Oddsiee/Line-Follower-Demi-UAS-Sinsis/Documentation/PROJECT.md

# PROJECT — Kontrak Antarmuka & Aturan Tim

## Kontrak antarmuka (jangan diubah sepihak)
| Modul | Fungsi | Keterangan |
|---|---|---|
| sensor | `Sensor_ReadRaw(uint16_t raw[16])` | Nilai ADC mentah 16 channel |
| sensor | `Sensor_GetPosition()` | -7500..+7500, 0 = garis di tengah |
| sensor | `Sensor_LineVisible()` | false jika garis hilang |
| motor | `Motor_Set(int16_t kiri, int16_t kanan)` | -1000..+1000 |
| motor | `Motor_Brake()`, `Motor_Coast()` | Rem aktif / bebas |
| params | `Params_t` (params.h) | Kp, Ki, Kd, base/max speed, kalibrasi, flag invert |

Selama kontrak ini tetap, tiap orang boleh memakai stub modul lain.

## Alur data
```
Sensor_ReadRaw -> Calibration (normalisasi) -> Sensor_GetPosition
  -> PID -> Motor_Set
  Track (persimpangan/CP/invert) memodifikasi base speed & flag invert
  UI menampilkan data dan mengedit Params_t; Storage menyimpan ke Flash
```

## Pembagian modul
| Peran | File |
|---|---|
| A | sensor, calibration, pid, Tools/uart_plot.py |
| B | motor, Tests/test_motor, dokumen hardware & pengukuran |
| C | ui, buttons, storage, track, app, params.h |
| Bersama | config.h, .ioc, README.md |

## Hal yang wajib diingat (dari dokumentasi master)
- Sensor: PA0 = Out1 (`ADC1_IN0`), PA1 = Out2 (`ADC1_IN1`), PA2 = Out3 (`ADC1_IN2`), PA3 = In1 (GPIO output), PB0 = In2 (GPIO output), PB1 = Out4 (`ADC1_IN9`). Rank ADC mengikuti urutan kanal 0, 1, 2, 9; selektor mux memakai GPIOA dan GPIOB.
- Tombol UP/DOWN/OK/BACK: PA7/PA6/PA5/PA4; HARD RESET: R (NRST).
- OLED I2C1: PB7 = SDA, PB6 = SCL. Kabel power OLED sudah diperbaiki dan teruji normal (2026-11-13); jangan mengasumsikan VCC/GND tertukar lagi.
- **`I2C1` wajib `100 kHz` (`ClockSpeed = 100000`)**, bukan `400 kHz` (`PB6/SCL` mengandalkan internal pull-up STM32 ~40 kOhm, `g_i2c_pd = 0x80`). Tambahkan delay settling **`150 ms`** sebelum init OLED saat ditenagai buck converter `3.3 V`.
- **Arsitektur tombol & UI anti-blocking:** `SH1106_Update()` di `100 kHz` memblokir `main()` ~`110 ms`, sehingga pembacaan tombol (`PA7/PA6/PA5/PA4`) wajib disampling **`1 kHz` di `SysTick_Handler`** (`12 ms` debounce, `500 ms` long-press) + antrean FIFO 8-slot, dipasangkan dengan dirty-driven OLED refresh (`400 ms` layar statis, `80 ms` layar sensor live, timestamp dicatat setelah render).
- Driver motor D0/D1/D2/D3: PA8/PA9/PA10/PA11 (`TIM1_CH1–CH4`).
- OLED memakai **SH1106**, bukan SSD1306 (pakai U8g2).
- Pin `3V3` dan `VT` di header ZK-5AD **tidak disambung**.
- Rem aktif = kedua pin driver HIGH; coast = kedua LOW.
- Batas regulasi: 20x20x10 cm, 3 kg, baterai 12 V +-1,5 V.
- PA11 tetap PWM motor kanan IN2; USB data tidak digunakan bersamaan dengan PWM pada pin ini. Flash/debug melalui SWD.

## Keputusan terbuka
- [ ] Verifikasi PA11 sebagai PWM motor dan konfigurasi USB data nonaktif (M1.3)
- [ ] Frekuensi PWM motor (M3.1)
- [ ] Periode loop kontrol (M8.1)
