Oddsiee/Line-Follower-Demi-UAS-Sinsis/Documentation/Milestones/M03_Driver.md

# Milestone 3 — Driver Motor

- **Pemilik:** B
- **Jadwal:** 7–11 Nov
- **Status:** belum mulai

## Tujuan
(isi satu-dua kalimat)

## Sub-milestone
- [ ] M3.1 Konfigurasi TIM1_CH1–CH4 pada PA8/PA9/PA10/PA11 untuk D0/D1/D2/D3; pilih frekuensi (coba 10–20 kHz)
- [ ] M3.2 Fungsi maju, mundur, rem aktif (kedua pin HIGH), coast (kedua pin LOW)
- [ ] M3.3 Motor_Set(kiri, kanan) dengan clamp -1000..+1000
- [ ] M3.4 Uji roda terangkat: arah putar benar, kiri/kanan tidak tertukar

## Selesai kalau
Kedua motor bisa dikontrol penuh lewat satu fungsi.

## Langkah yang dikerjakan
(catat langkah penting, setting CubeMX, library yang dipakai)

## Hasil uji
| Uji | Hasil | Catatan |
|---|---|---|
| | | |

## Masalah & solusi
- 

## Catatan untuk milestone berikutnya
-
