Oddsiee/Line-Follower-Demi-UAS-Sinsis/Documentation/Milestones/M06_Karakterisasi.md

# Milestone 6 — Karakterisasi Motor

- **Pemilik:** B
- **Jadwal:** 12–16 Nov
- **Status:** belum mulai

## Tujuan
(isi satu-dua kalimat)

## Sub-milestone
- [ ] M6.1 Ukur deadband (PWM minimum agar roda berputar) dan kompensasi
- [ ] M6.2 Seimbangkan kiri-kanan agar lurus saat perintah sama
- [ ] M6.3 Ramp akselerasi dan cek lonjakan arus saat stall
- [ ] M6.4 Safe-stop (rem) lewat satu fungsi; uji LiPo 3S saat beban

## Selesai kalau
Robot jalan lurus di lantai dan berhenti dengan baik.

## Langkah yang dikerjakan
(catat langkah penting, setting CubeMX, library yang dipakai)

## Hasil uji
| Uji | Hasil | Catatan |
|---|---|---|
| | | |

## Masalah & solusi
- 

## Catatan untuk milestone berikutnya
-
