Oddsiee/Line-Follower-Demi-UAS-Sinsis/Documentation/Milestones/M08_Integrasi.md

# Milestone 8 — Integrasi PID

- **Pemilik:** A (B, C mendukung)
- **Jadwal:** 17–21 Nov
- **Status:** belum mulai

## Tujuan
(isi satu-dua kalimat)

## Sub-milestone
- [ ] M8.1 Loop kontrol periode tetap (timer interrupt, mulai 2–5 ms)
- [ ] M8.2 PID: error = posisi, output dibagi ke motor kiri/kanan di sekitar base speed
- [ ] M8.3 Tuning awal: garis lurus lalu belokan landai (Kp, lalu Kd, lalu Ki kecil/nol)
- [ ] M8.4 Tampilkan data live (posisi, error, speed) di OLED

## Selesai kalau
Robot mengikuti lintasan sederhana satu putaran penuh.

## Langkah yang dikerjakan
(catat langkah penting, setting CubeMX, library yang dipakai)

## Hasil uji
| Uji | Hasil | Catatan |
|---|---|---|
| | | |

## Masalah & solusi
- 

## Catatan untuk milestone berikutnya
-
