Oddsiee/Line-Follower-Demi-UAS-Sinsis/Documentation/Milestones/M11_Pengujian.md

# Milestone 11 — Pengujian & Regulasi

- **Pemilik:** Semua
- **Jadwal:** 25–26 Nov
- **Status:** belum mulai

## Tujuan
(isi satu-dua kalimat)

## Sub-milestone
- [ ] M11.1 Cek dimensi (maks 20x20x10 cm), berat (maks 3 kg), tegangan baterai (12 V +-1,5 V)
- [ ] M11.2 Simulasi lomba: waktu terbatas, mulai dari menu
- [ ] M11.3 Uji ketahanan: cahaya berbeda dan baterai setengah habis

## Selesai kalau
Robot lolos cek regulasi dan simulasi. 27 Nov: freeze firmware.

## Langkah yang dikerjakan
(catat langkah penting, setting CubeMX, library yang dipakai)

## Hasil uji
| Uji | Hasil | Catatan |
|---|---|---|
| | | |

## Masalah & solusi
- 

## Catatan untuk milestone berikutnya
-
