Oddsiee/Line-Follower-Demi-UAS-Sinsis/Documentation/Milestones/M07_Parameter.md

# Milestone 7 — Parameter & Penyimpanan

- **Pemilik:** C
- **Jadwal:** 12–16 Nov
- **Status:** belum mulai

## Tujuan
(isi satu-dua kalimat)

## Sub-milestone
- [ ] M7.1 Layar edit Kp, Ki, Kd, base speed, max speed
- [ ] M7.2 Simpan Params & kalibrasi ke sektor Flash terakhir (sektor 7); tulis hanya saat IDLE
- [ ] M7.3 Muat otomatis saat boot, validasi magic number / checksum
- [ ] M7.4 State machine: IDLE -> CALIB -> READY -> RUN -> STOP

## Selesai kalau
Parameter tetap tersimpan setelah power off.

## Langkah yang dikerjakan
(catat langkah penting, setting CubeMX, library yang dipakai)

## Hasil uji
| Uji | Hasil | Catatan |
|---|---|---|
| | | |

## Masalah & solusi
- 

## Catatan untuk milestone berikutnya
-
