Oddsiee/Line-Follower-Demi-UAS-Sinsis/Documentation/Milestones/M09_Logika.md

# Milestone 9 — Logika Lintasan

- **Pemilik:** C (A mendukung, B lintasan uji)
- **Jadwal:** 17–21 Nov
- **Status:** belum mulai

## Tujuan
(isi satu-dua kalimat)

## Sub-milestone
- [ ] M9.1 Deteksi persimpangan dan percabangan
- [ ] M9.2 Indexing path / checkpoint CP 1–4
- [ ] M9.3 Mode invert untuk blok "TED 2026" dan petir
- [ ] M9.4 Lintasan uji sesuai guidebook dan profil kecepatan

## Selesai kalau
Satu putaran lintasan lengkap selesai, walau belum cepat.

## Langkah yang dikerjakan
(catat langkah penting, setting CubeMX, library yang dipakai)

## Hasil uji
| Uji | Hasil | Catatan |
|---|---|---|
| | | |

## Masalah & solusi
- 

## Catatan untuk milestone berikutnya
-
