Oddsiee/Line-Follower-Demi-UAS-Sinsis/Documentation/Milestones/M01_Bring-up.md

# Milestone 1 — Bring-up Hardware

- **Pemilik:** Semua
- **Jadwal:** 4–6 Nov
- **Status:** belum mulai

## Tujuan
(isi satu-dua kalimat)

## Sub-milestone
- [x] M1.1 Buat `.ioc` sesuai pinout master (ADC1 PA0/PA1/PA2/PB1 pada IN0/IN1/IN2/IN9 untuk Out1–Out4, GPIO PA3=In1 dan PB0=In2, TIM1 PA8–PA11, I2C1 PB6=SCL/PB7=SDA, tombol UP/DOWN/OK/BACK di PA7/PA6/PA5/PA4, reset R/NRST, USART1 debug)
- [ ] M1.2 Cek rail 3V3, GND, polaritas sebelum baterai dipasang; pin 3V3 & VT ZK-5AD tetap NC
- [ ] M1.3 Verifikasi PA11 tetap sebagai TIM1_CH4 (DRV_D3); nonaktifkan USB data saat PWM motor digunakan dan gunakan SWD untuk flash/debug
- [ ] M1.4 Uji flash via SWD dan UART debug

## Selesai kalau
Firmware kosong ter-flash dan UART mencetak teks uji.

## Langkah yang dikerjakan
(catat langkah penting, setting CubeMX, library yang dipakai)

## Hasil uji
| Uji | Hasil | Catatan |
|---|---|---|
| | | |

## Masalah & solusi
- 

## Catatan untuk milestone berikutnya
-
