Oddsiee/Line-Follower-Demi-UAS-Sinsis/Documentation/Milestones/M10_Tuning.md

# Milestone 10 — Tuning Lintasan

- **Pemilik:** Semua
- **Jadwal:** 22–25 Nov
- **Status:** belum mulai

## Tujuan
(isi satu-dua kalimat)

## Sub-milestone
- [ ] M10.1 A: tuning PID dan kecepatan maksimum
- [ ] M10.2 B: mekanik (tinggi sensor, bobot, roda) dan konsistensi baterai
- [ ] M10.3 C: catat hasil tiap run dan simpan beberapa profil parameter
- [ ] M10.4 Uji berulang minimal 10x tanpa keluar jalur

## Selesai kalau
10 run berturut-turut stabil.

## Langkah yang dikerjakan
(catat langkah penting, setting CubeMX, library yang dipakai)

## Hasil uji
| Uji | Hasil | Catatan |
|---|---|---|
| | | |

## Masalah & solusi
- 

## Catatan untuk milestone berikutnya
-
