Oddsiee/Line-Follower-Demi-UAS-Sinsis/Documentation/Milestones/M05_Kalibrasi.md

# Milestone 5 — Kalibrasi & Posisi Garis

- **Pemilik:** A
- **Jadwal:** 12–16 Nov
- **Status:** belum mulai

## Tujuan
(isi satu-dua kalimat)

## Sub-milestone
- [ ] M5.1 Rutinitas kalibrasi: sapu hitam dan putih, simpan min/max tiap channel
- [ ] M5.2 Threshold / normalisasi 0–1000 per channel
- [ ] M5.3 Posisi garis dengan weighted average 16 channel (pusat = 0)
- [ ] M5.4 Penanganan garis hilang (ingat arah terakhir) dan mode invert

## Selesai kalau
Posisi bergerak mulus saat garis digeser manual, termasuk mode invert.

## Langkah yang dikerjakan
(catat langkah penting, setting CubeMX, library yang dipakai)

## Hasil uji
| Uji | Hasil | Catatan |
|---|---|---|
| | | |

## Masalah & solusi
- 

## Catatan untuk milestone berikutnya
-
