Oddsiee/Line-Follower-Demi-UAS-Sinsis/Firmware/LF_TED2026/Tes_Oled_Sensor_Baru.ioc

Mcu.UserName=STM32F411CEUx
PA0-WKUP.Signal=ADCx_IN0
PA1.Signal=ADCx_IN1
PA10.Signal=S_TIM1_CH3
PA11.Signal=S_TIM1_CH4
PA13.Signal=SYS_JTMS-SWDIO
PA14.Signal=SYS_JTCK-SWCLK
PA15.Signal=USART1_TX
PA2.Signal=ADCx_IN2
PA3.Signal=GPIO_Output
PA4.Signal=GPIO_Input
PA5.Signal=GPIO_Input
PA6.Signal=GPIO_Input
PA7.Signal=GPIO_Input
PA8.Signal=S_TIM1_CH1
PA9.Signal=S_TIM1_CH2
PB0.Signal=GPIO_Output
PB1.Signal=ADCx_IN9
PB3.Signal=USART1_RX
PB6.Signal=I2C1_SCL
PB7.Signal=I2C1_SDA
PC13-ANTI_TAMP.Signal=GPIO_Output
