Oddsiee/Line-Follower-Demi-UAS-Sinsis/Firmware/LF_TED2026/Core/Src/sh1106.c

#include "sh1106.h"
#include "stm32f4xx_hal.h"
#include <stddef.h>

/* Handle I2C dari CubeMX (default hi2c1, global di main.c). */
extern I2C_HandleTypeDef SH1106_HI2C;

#define SH1106_TIMEOUT 100U

/* Framebuffer: 8 halaman x 128 kolom. 1 byte = 8 piksel vertikal,
 * bit 0 = piksel paling atas dalam halaman. */
static uint8_t s_fb[8][SH1106_WIDTH];
static uint8_t s_addr7 = SH1106_I2C_ADDR;

/* Statistik untuk diagnosa (bisa dibaca via SWD). */
volatile uint32_t g_sh1106_ok   = 0;
volatile uint32_t g_sh1106_fail = 0;
volatile uint32_t g_sh1106_last = 0;
volatile uint32_t g_sh1106_recover = 0;
volatile uint32_t g_sh1106_scan_count = 0;
volatile uint32_t g_sh1106_scan_lo = 0;
volatile uint32_t g_sh1106_scan_hi = 0;

/* ============================================================
 * Font 6x8 (ASCII 32..126). 6 byte/glyph = 6 kolom, bit 0 = baris atas.
 * Di-generate oleh Tools/gen_font.py (Consolas, supersampled).
 * ============================================================ */
static const uint8_t FONT6x8[95][6] = {
    {0x00, 0x00, 0x00, 0x00, 0x00, 0x00}, /*  32 ' ' */
    {0x00, 0x00, 0x9F, 0x00, 0x00, 0x00}, /*  33 '!' */
    {0x3C, 0x3C, 0x00, 0x00, 0x3C, 0x3C}, /*  34 '\"' */
    {0x10, 0x7E, 0x17, 0x74, 0x1F, 0x00}, /*  35 '#' */
    {0x00, 0x44, 0xCA, 0x5B, 0x30, 0x00}, /*  36 '$' */
    {0x42, 0x25, 0x13, 0x64, 0x52, 0x21}, /*  37 '%' */
    {0x30, 0x4F, 0x4D, 0x77, 0x70, 0x00}, /*  38 '&' */
    {0x00, 0xFF, 0xFF, 0xFF, 0x03, 0x00}, /*  39 '\'' */
    {0x00, 0x00, 0x3C, 0x81, 0x00, 0x00}, /*  40 '(' */
    {0x00, 0x00, 0x81, 0x3C, 0x00, 0x00}, /*  41 ')' */
    {0x24, 0x18, 0x7E, 0x18, 0x18, 0x24}, /*  42 '*' */
    {0x10, 0x18, 0x7E, 0x7E, 0x18, 0x10}, /*  43 '+' */
    {0x40, 0x60, 0x62, 0x3F, 0x1F, 0x0E}, /*  44 ',' */
    {0x08, 0x08, 0x08, 0x08, 0x08, 0x08}, /*  45 '-' */
    {0x38, 0x7C, 0x7E, 0x7E, 0x3C, 0x18}, /*  46 '.' */
    {0x00, 0x80, 0x30, 0x0C, 0x01, 0x00}, /*  47 '/' */
    {0x7E, 0xF3, 0x99, 0xCF, 0x7E, 0x00}, /*  48 '0' */
    {0x82, 0x83, 0xFF, 0x80, 0x80, 0x00}, /*  49 '1' */
    {0x80, 0xC1, 0xB1, 0x9F, 0x84, 0x00}, /*  50 '2' */
    {0x00, 0x81, 0x89, 0x99, 0x76, 0x00}, /*  51 '3' */
    {0x10, 0x1C, 0x26, 0x33, 0x7F, 0x00}, /*  52 '4' */
    {0x00, 0x8F, 0x89, 0xC9, 0x71, 0x00}, /*  53 '5' */
    {0x7C, 0xCA, 0x89, 0x89, 0x70, 0x00}, /*  54 '6' */
    {0x01, 0xC1, 0x71, 0x0D, 0x03, 0x00}, /*  55 '7' */
    {0x66, 0x9D, 0x89, 0x99, 0x66, 0x00}, /*  56 '8' */
    {0x0E, 0x91, 0x91, 0x53, 0x3E, 0x00}, /*  57 '9' */
    {0x00, 0x00, 0xC3, 0xC3, 0x00, 0x00}, /*  58 ':' */
    {0x00, 0x00, 0x80, 0x73, 0x00, 0x00}, /*  59 ';' */
    {0x18, 0x18, 0x24, 0x42, 0x81, 0x00}, /*  60 '<' */
    {0x14, 0x14, 0x14, 0x14, 0x14, 0x14}, /*  61 '=' */
    {0x81, 0x42, 0x24, 0x18, 0x18, 0x00}, /*  62 '>' */
    {0x00, 0x91, 0x99, 0x0E, 0x00, 0x00}, /*  63 '?' */
    {0x00, 0x78, 0xA1, 0x25, 0x1E, 0x00}, /*  64 '@' */
    {0x60, 0x3C, 0x33, 0x33, 0x3C, 0x60}, /*  65 'A' */
    {0xFF, 0x99, 0x89, 0xDB, 0x76, 0x00}, /*  66 'B' */
    {0x3C, 0xC2, 0x81, 0x81, 0x81, 0x00}, /*  67 'C' */
    {0xFF, 0x81, 0x81, 0xC3, 0x3E, 0x00}, /*  68 'D' */
    {0x00, 0xFF, 0x89, 0x89, 0x89, 0x00}, /*  69 'E' */
    {0x00, 0xFF, 0x19, 0x19, 0x01, 0x00}, /*  70 'F' */
    {0x7C, 0xC3, 0x81, 0x99, 0xF1, 0x00}, /*  71 'G' */
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
};

/* ============================================================
 * I2C low-level
 * ============================================================ */

/* ============================================================
 * Bus recovery
 *
 * Masalah nyata yang terukur: flag BUSY di I2C1 bisa macet permanen
 * (SR2.BUSY = 1) sehingga SEMUA transaksi mengembalikan HAL_BUSY.
 * __HAL_RCC_I2C1_FORCE_RESET() saja TIDAK cukup untuk membersihkannya.
 * Yang terbukti bekerja: bit SWRST di I2C_CR1.
 *
 * Urutan:
 *   1. Lepas pin dari AF -> GPIO open-drain, clock SCL 9x (bebaskan slave
 *      yang menahan SDA), lalu STOP.
 *   2. SWRST pulse untuk reset state machine peripheral.
 *   3. Kembalikan pin ke AF4, init ulang HAL.
 *   4. Verifikasi SR2.BUSY == 0; ulangi bila perlu.
 * ============================================================ */
static void i2c_swrst(void)
{
    /* RM0090: SWRST hanya bisa di-set saat peripheral DISABLE (PE=0).
     * Kalau PE masih 1, tulisan SWRST DIABAIKAN dan flag BUSY tetap macet.
     * Urutan wajib: PE=0 -> SWRST=1 -> SWRST=0 -> PE=1. */
    I2C_TypeDef *i2c = SH1106_HI2C.Instance;

    i2c->CR1 &= ~I2C_CR1_PE;          /* 1. disable peripheral */
    for (volatile int d = 0; d < 50; d++) { }

    i2c->CR1 |=  I2C_CR1_SWRST;       /* 2. reset state machine */
    for (volatile int d = 0; d < 50; d++) { }

    i2c->CR1 &= ~I2C_CR1_SWRST;       /* 3. lepas reset */
    for (volatile int d = 0; d < 50; d++) { }

    i2c->CR1 |=  I2C_CR1_PE;          /* 4. enable kembali */
    for (volatile int d = 0; d < 50; d++) { }
}

static void i2c_bus_recover(void)
{
    GPIO_InitTypeDef g = {0};

    /* --- 1. bit-bang: lepas slave yang menahan SDA --- */
    g.Pin       = GPIO_PIN_6 | GPIO_PIN_7;
    g.Mode      = GPIO_MODE_OUTPUT_OD;
    g.Pull      = GPIO_PULLUP;
    g.Speed     = GPIO_SPEED_FREQ_VERY_HIGH;
    HAL_GPIO_Init(GPIOB, &g);

    HAL_GPIO_WritePin(GPIOB, GPIO_PIN_7, GPIO_PIN_SET);   /* SDA high */
    for (int i = 0; i < 9; i++) {
        HAL_GPIO_WritePin(GPIOB, GPIO_PIN_6, GPIO_PIN_RESET);
        for (volatile int d = 0; d < 200; d++) { }
        HAL_GPIO_WritePin(GPIOB, GPIO_PIN_6, GPIO_PIN_SET);
        for (volatile int d = 0; d < 200; d++) { }
    }
    /* kondisi STOP: SDA low -> SCL high -> SDA high */
    HAL_GPIO_WritePin(GPIOB, GPIO_PIN_7, GPIO_PIN_RESET);
    for (volatile int d = 0; d < 200; d++) { }
    HAL_GPIO_WritePin(GPIOB, GPIO_PIN_6, GPIO_PIN_SET);
    for (volatile int d = 0; d < 200; d++) { }
    HAL_GPIO_WritePin(GPIOB, GPIO_PIN_7, GPIO_PIN_SET);
    for (volatile int d = 0; d < 200; d++) { }

    /* --- 2. reset peripheral (SWRST terbukti membersihkan BUSY) --- */
    i2c_swrst();

    /* --- 3. kembalikan pin ke AF4 I2C1 --- */
    g.Mode      = GPIO_MODE_AF_OD;
    g.Alternate = GPIO_AF4_I2C1;
    HAL_GPIO_Init(GPIOB, &g);

    /* --- 4. init ulang HAL + verifikasi BUSY hilang --- */
    SH1106_HI2C.State = HAL_I2C_STATE_RESET;
    HAL_I2C_Init(&SH1106_HI2C);

    for (int t = 0; t < 3; t++) {
        if ((SH1106_HI2C.Instance->SR2 & I2C_SR2_BUSY) == 0U) break;
        i2c_swrst();
        SH1106_HI2C.State = HAL_I2C_STATE_RESET;
        HAL_I2C_Init(&SH1106_HI2C);
    }
}

/* Scan bus I2C 0x08..0x77. Bit i = alamat (0x08+i) untuk i<0x38,
 * sisanya di *hi. Mengembalikan jumlah device yang ACK. */
uint32_t SH1106_Scan(uint32_t *lo, uint32_t *hi)
{
    uint32_t n = 0;
    if (lo) *lo = 0;
    if (hi) *hi = 0;

    for (uint8_t a = 0x08; a <= 0x77; a++) {
        if (HAL_I2C_IsDeviceReady(&SH1106_HI2C, (uint16_t)(a << 1), 2, 10) == HAL_OK) {
            if (a < 0x40) { if (lo) *lo |= (1UL << (a - 0x08)); }
            else          { if (hi) *hi |= (1UL << (a - 0x40)); }
            n++;
        }
    }
    return n;
}

static void write_cmd(uint8_t cmd)
{
    /* control byte 0x00 = perintah */
    HAL_StatusTypeDef st = HAL_I2C_Mem_Write(&SH1106_HI2C, (uint16_t)(s_addr7 << 1), 0x00,
                                             I2C_MEMADD_SIZE_8BIT, &cmd, 1, SH1106_TIMEOUT);

    /* BUSY macet = peripheral perlu di-recover, bukan sekadar retry. */
    if (st == HAL_BUSY) {
        g_sh1106_recover++;
        i2c_bus_recover();
        st = HAL_I2C_Mem_Write(&SH1106_HI2C, (uint16_t)(s_addr7 << 1), 0x00,
                               I2C_MEMADD_SIZE_8BIT, &cmd, 1, SH1106_TIMEOUT);
    }

    g_sh1106_last = (uint32_t)st;
    if (st == HAL_OK) g_sh1106_ok++; else g_sh1106_fail++;
}

static void write_data(const uint8_t *data, uint16_t len)
{
    /* control byte 0x40 = data */
    HAL_I2C_Mem_Write(&SH1106_HI2C, (uint16_t)(s_addr7 << 1), 0x40,
                      I2C_MEMADD_SIZE_8BIT, (uint8_t *)data, len, SH1106_TIMEOUT);
}

/* ============================================================
 * Init
 * ============================================================ */
void SH1106_Init(void)
{
    /* Kalau MCU reset di tengah transaksi I2C, slave bisa menahan SDA LOW
     * dan flag BUSY jadi macet. Recover dulu sebelum init. */
    i2c_bus_recover();

    /* Jika gambar terbalik/mirror, tukar 0xA1<->0xA0 dan 0xC8<->0xC0. */
    static const uint8_t init[] = {
        0xAE,          /* display off                  */
        0xD5, 0x80,    /* clock divide ratio           */
        0xA8, 0x3F,    /* multiplex ratio = 64         */
        0xD3, 0x00,    /* display offset = 0           */
        0x40,          /* start line = 0               */
        0xAD, 0x8B,    /* charge pump ON (khas SH1106) */
        0xA1,          /* segment remap                */
        0xC8,          /* COM scan direction remapped  */
        0xDA, 0x12,    /* COM pins hardware config     */
        0x81, 0xCF,    /* contrast                     */
        0xD9, 0x22,    /* pre-charge period            */
        0xDB, 0x35,    /* VCOM deselect level          */
        0xA4,          /* resume dari all-on           */
        0xA6,          /* normal (bukan invert)        */
        0xAF           /* display on                   */
    };
    for (size_t i = 0; i < sizeof(init) / sizeof(init[0]); i++) {
        write_cmd(init[i]);
    }
    SH1106_Clear();
    SH1106_Update();
}

void SH1106_Clear(void)
{
    for (int p = 0; p < 8; p++) {
        for (int x = 0; x < SH1106_WIDTH; x++) {
            s_fb[p][x] = 0x00;
        }
    }
}

void SH1106_Update(void)
{
    for (uint8_t page = 0; page < 8; page++) {
        write_cmd((uint8_t)(0xB0 | page));  /* set page address        */
        write_cmd(0x02);                    /* kolom bawah = 2         */
        write_cmd(0x10);                    /* kolom atas  = 0         */
        write_data(s_fb[page], SH1106_WIDTH);
    }
}

bool SH1106_Probe(uint8_t addr7)
{
    return HAL_I2C_IsDeviceReady(&SH1106_HI2C, (uint16_t)(addr7 << 1), 2, 10)
           == HAL_OK;
}

void SH1106_SetAddress(uint8_t addr7)
{
    s_addr7 = addr7;
}

/* ============================================================
 * Drawing
 * ============================================================ */
void SH1106_SetPixel(int x, int y, bool on)
{
    if (x < 0 || x >= SH1106_WIDTH || y < 0 || y >= SH1106_HEIGHT) return;
    uint8_t page = (uint8_t)(y >> 3);
    uint8_t bit  = (uint8_t)(1U << (y & 7));
    if (on) s_fb[page][x] |=  bit;
    else    s_fb[page][x] &= (uint8_t)~bit;
}

void SH1106_DrawLine(int x0, int y0, int x1, int y1, bool on)
{
    int dx = x1 > x0 ? x1 - x0 : x0 - x1;
    int dy = y1 > y0 ? y1 - y0 : y0 - y1;
    int sx = x0 < x1 ? 1 : -1;
    int sy = y0 < y1 ? 1 : -1;
    int err = dx - dy;

    for (;;) {
        SH1106_SetPixel(x0, y0, on);
        if (x0 == x1 && y0 == y1) break;
        int e2 = 2 * err;
        if (e2 > -dy) { err -= dy; x0 += sx; }
        if (e2 <  dx) { err += dx; y0 += sy; }
    }
}

void SH1106_DrawRect(int x, int y, int w, int h, bool on)
{
    SH1106_DrawLine(x,     y,     x + w - 1, y,         on);
    SH1106_DrawLine(x,     y + h - 1, x + w - 1, y + h - 1, on);
    SH1106_DrawLine(x,     y,     x,     y + h - 1, on);
    SH1106_DrawLine(x + w - 1, y, x + w - 1, y + h - 1, on);
}

void SH1106_DrawFillRect(int x, int y, int w, int h, bool on)
{
    for (int yy = y; yy < y + h; yy++) {
        SH1106_DrawLine(x, yy, x + w - 1, yy, on);
    }
}

void SH1106_DrawCircle(int cx, int cy, int r, bool on)
{
    int x = 0, y = r, d = 3 - 2 * r;
    while (y >= x) {
        SH1106_SetPixel(cx + x, cy + y, on);
        SH1106_SetPixel(cx - x, cy + y, on);
        SH1106_SetPixel(cx + x, cy - y, on);
        SH1106_SetPixel(cx - x, cy - y, on);
        SH1106_SetPixel(cx + y, cy + x, on);
        SH1106_SetPixel(cx - y, cy + x, on);
        SH1106_SetPixel(cx + y, cy - x, on);
        SH1106_SetPixel(cx - y, cy - x, on);
        if (d < 0) {
            d += 4 * x + 6;
        } else {
            d += 4 * (x - y) + 10;
            y--;
        }
        x++;
    }
}

void SH1106_DrawFillCircle(int cx, int cy, int r, bool on)
{
    for (int y = -r; y <= r; y++) {
        int half = 0;
        while ((half + 1) * (half + 1) + y * y <= r * r) half++;
        SH1106_DrawLine(cx - half, cy + y, cx + half, cy + y, on);
    }
}

void SH1106_DrawChar(int x, int y, char c)
{
    int idx = (int)c - 32;
    if (idx < 0 || idx >= 95) idx = 0;   /* karakter di luar tabel -> spasi */
    for (int col = 0; col < 6; col++) {
        uint8_t bits = FONT6x8[idx][col];
        for (int row = 0; row < 8; row++) {
            if (bits & (1U << row)) {
                SH1106_SetPixel(x + col, y + row, true);
            }
        }
    }
}

void SH1106_DrawString(int x, int y, const char *s)
{
    while (*s) {
        SH1106_DrawChar(x, y, *s++);
        x += 6;
    }
}
