Oddsiee/Line-Follower-Demi-UAS-Sinsis/(commit log)

2026-11-02 Add Workspace STM32
2026-11-04 Upload file line track
2026-11-05 [M4] ui: test OLED SH1106 (driver HAL + demo + docs)
2026-11-05 Driver SH1106
2026-11-05 feat(tests): standalone OLED test buildable without CubeIDE
    - Tests/test_oled: main.c, hal_conf, it.c, linker script
    - build.ps1: compile+link with bundled ARM GCC, no CubeIDE needed
    - flash.ps1: flash via STM32_Programmer_CLI (SWD, verify, reset)
    - Verified: text 11820B, flashed & verified on STM32F411CEU6
    - TEST_OLED.md: document firmware package workaround (st.com unreachable)
    - .gitignore: ignore build/, *.hex, *.bin
    [main.c]
2026-11-05 test(oled): hardware diagnostics — OLED not detected on I2C bus
    Measured directly from MCU registers via SWD:
    - I2C scan 0x08..0x77 on 5 buses (bitbang PB6/7, I2C1 PB6/7, I2C1 PB8/9,
    I2C2 PB10/11, I2C3 PA8/PC9): 0 devices found
    - Pin test: MCU can drive HIGH (0xC0) and LOW (0x00) — pins healthy
    - Pull-down test: lines read LOW => NO external pull-up on bus
    - Pull-up test: lines read HIGH => no short to GND
    Conclusion: physical/electrical issue, not firmware.
    Likely: OLED unpowered, pin order reversed (GND-VCC vs VCC-GND), or dead module.
    Added: diag_main.c, pin_test.c, multibus.c, pullup_test.c + runner scripts
    Added: DIAGNOSA.md with measurements and next steps
    [diag_main.c, multibus.c, pin_test.c, pullup_test.c]
2026-11-05 fix(oled): enable I2C1 clock — OLED now works
    Root cause: MX_I2C1_Init() never called __HAL_RCC_I2C1_CLK_ENABLE().
    Without the peripheral clock, I2C1 registers are inaccessible, so every
    I2C scan returned 0 devices — indistinguishable from 'OLED not connected'.
    Fixes:
    - Tests/test_oled/main.c: add __HAL_RCC_I2C1_CLK_ENABLE()
    - sh1106.c: add i2c_bus_recover() in SH1106_Init() — 9 SCL clocks +
    peripheral reset + HAL_I2C_Init, so BUSY flag cannot latch permanently
    - sh1106.c: add g_sh1106_ok/g_sh1106_fail/g_sh1106_last counters for SWD diag
    Verified on hardware: g_sh1106_ok increments, g_sh1106_fail = 0, OLED displays.
    Also added diagnostic tools: slow_scan.c, speed_test.c, hold_test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
    [hold_test.c, main.c, sh1106.c, slow_scan.c, speed_test.c]
2026-11-05 [M2] sensor: firmware test 16CH + baseline putih terukur
    - Tests/test_sensor: build/flash/read standalone (ADC1 PA4-PA7 + mux PB0/PB1)
    - Oversampling 4x, settling 50us, scan penuh 9.1ms
    - build_diag/read_diag: VREFINT + polling vs DMA + karakterisasi mux
    - Documentation/Hardware/LOG_SENSOR.md: data pengukuran nyata
    - M02_Sensor.md: progres + 4 masalah & solusi terdokumentasi
    Temuan utama: GND power supply wajib disambung ke GND STM32.
    Tanpa itu nilai acak 0..950 dan ST-Link DEV_CONNECT_ERR.
2026-11-05 Testing sensor dan OLED, serta kalibrasi warna putih pada sensor
2026-11-10 Test OLED After Assembly
